klapstoelpiloot/buttontoy/src/Defines.h

#pragma once

#define PIN_BUTTONS		    21
#define PIN_SPEAKER        3
#define PIN_BUTTON_LEDS    5
#define PIN_RED0           2
#define PIN_GREEN0         4
#define PIN_BLUE0          6
#define PIN_RED1           7
#define PIN_GREEN1         8
#define PIN_BLUE1          9
#define PIN_RED2          10
#define PIN_GREEN2        11
#define PIN_BLUE2         12
#define PIN_RED3          14
#define PIN_GREEN3        15
#define PIN_BLUE3         16
#define PIN_RED4          17
#define PIN_GREEN4        18
#define PIN_BLUE4         19
#define PIN_UNCONNECTED   20

#define NUM_BUTTONS        5
#define NUM_LEDS           5

// LED states. These numbers match with the bits for RGB.
#define OFF                0
#define BLUE               1
#define GREEN              2
#define CYAN               3
#define RED                4
#define PURPLE             5
#define YELLOW             6
#define WHITE              7
