klapstoelpiloot/buttontoy/src/Puzzles/FiveStateToggle.h

#undef PUZZLE
#define PUZZLE FiveStateToggle
#include "../PuzzleTemplate.h"

PUZZLE::PUZZLE()
{
}

void PUZZLE::Enter()
{
    // Start with the LEDs in random combinations.
    for(int i = 0; i < NUM_LEDS; i++)
    {
        leds.Set(i, RandomColorNoGreen());
    }
}

void PUZZLE::Leave()
{
}

void PUZZLE::Update()
{
}

void PUZZLE::OnButtonPress(int index)
{
    leds.Set(index, ALL_COLORS[(ColorIndex(leds.Get(index)) + 1) % ALL_COLORS_COUNT]);
}

void PUZZLE::OnButtonRelease(int index)
{
}
