klapstoelpiloot/buttontoy/(commit log)

2023-05-18 Button analog input test
2023-05-18 Some work on the analog button reading
2023-05-19 Added wiring diagrams
2023-05-21 More changes and bug fixes and another puzzle
    [ButtonToy.ino, RewardState.cpp, RewardState.h, Speaker.cpp]
2023-05-24 Reworded the part about buttons decoding
2023-06-04 Added some more puzzles and removed two that were too much the same as others.
    [ButtonToy.ino, CycleSequence.h, LeftRightSwap.h, RandomOrder.h]
